Colorado-School-of-Mines-Robotics-Club/MATE_ROV_Electronics/README.md

# MinesROV Electronics
Git Repo for CSM MateROV Electronics
