Colorado-School-of-Mines-Robotics-Club/MATE_ROV_Electronics/Mock Electrical Diagram R2.jpg

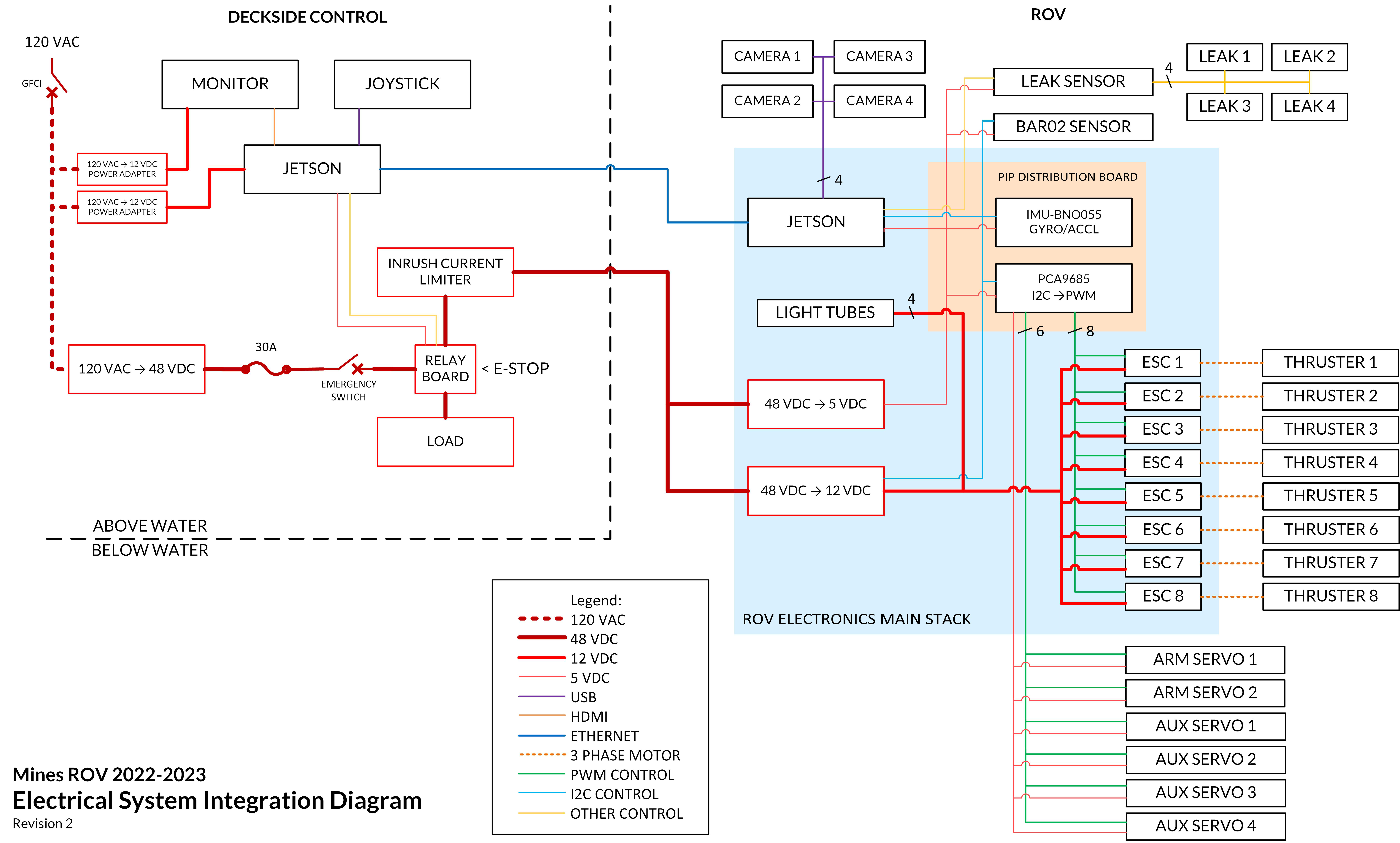
Mock Electrical Diagram R2.jpg
