Colorado-School-of-Mines-Robotics-Club/MATE_ROV_Electronics/2021-2022 Electronics/DCDC_4805/Project Outputs for DCDC_4805/DCDC_4805.xlsx

Comment | Description | Designator | Footprint | LibRef | Quantity
330uF 100V | Panasonic CAP ALUM 330UF 20% 100V SMD | C1 | EEV-FK2A331M | EEV-FK2A331M | 1
15uF 100V | TDK CAP CER 15UF 100V X7S 2220 | C2 | C2220M Generic | C5750X7S2A156M250KB | 1
100uF 10V | Wurth CAP ALUM POLY 100UF 20% 10V SMD | C3, C4, C5, C6 | 865080243007 | 865080243007 | 4
22uF 10V | Wurth CAP CER 22UF 10V X5R 0805 | C7 | 885012107011 | 885012107011 | 1
12V 250mW | Nexperia DIODE ZENER 12V 250MW TO236AB | D1 | BZX84-C12,235 | BZX84-C12,235 | 1
125VDC 5A | Littelfuse FUSE BRD MNT 5A 125VAC/VDC 2SMD | F1 | 0154005.DRL | 0154005.DRL | 1
M3 | MECHANICAL M3 Mounting Hole | H1, H2, H3, H4 | M3_MOUNTING_HOLE | M3_Mounting_Hole | 4
M5x3.5mm | Wurth WP-THRBU REDCUBE THR internal through-hole thread, 10x10mm, M5x3.5mm, 8 pins, 85A | J1, J2 | 74655095 | 74655095R | 2
JST-XH 2POS VERT | JST XH CONN HEADER VERT 2POS 2.5MM | J3, J4, J5, J6, J7, J8, J9, J10, J11, J12, J13, J14, J15, J16, J17, J18, J21 | FP-B2B-XH-A_LF_SN-MFG | B2B-XH-A(LF)(SN) | 17
M3x2.5mm | Wurth WP-THRBU REDCUBE THR internal through-hole thread, 7x7mm, M3x2.5mm, 4 pins, 50A | J19, J20 | 74650073 | 74650073R | 2
100kΩ | Stackpole RES 100K OHM 1% 1/8W 0805 | R1, R2, R3 | RMCF0805 | RMCF0805FT100K | 3
P-CH FET 100V | Infineon MOSFET P-CH 100V 14A D2PAK | U1 | IRF9530NSTRLPBF | IRF9530NSTRLPBF | 1
48V/5V 200W | Flex Power DC DC CONVERTER 5V 200W | U2 | PKB4211DPI | PKB4211DPI | 1
