Colorado-School-of-Mines-Robotics-Club/MATE_ROV_Electronics/2021-2022 Electronics/DCDC_4812/Project Outputs for DCDC_4812/DCDC_4812.xlsx

Comment | Description | Designator | Footprint | LibRef | Quantity
470uF 100V | Vishay CAP ALUM 470UF 20% 100V SMD | C1 | MAL2150_CASE1821 | MAL215099913E3 | 1
15uF 100V | TDK CAP CER 15UF 100V X7S 2220 | C2 | C2220M Generic | C5750X7S2A156M250KB | 1
470uF 16V | Wurth CAP ALUM POLY 470UF 20% 16V SMD | C3, C4, C5, C6 | 875115357006 | 875115357006 | 4
15uF 25V | TDK CAP CER 15UF 25V X5R 0805 | C7 | C2012M Generic | C2012X5R1E156M125AC | 1
12V 250mW | Nexperia DIODE ZENER 12V 250MW TO236AB | D1 | BZX84-C12,235 | BZX84-C12,235 | 1
72VDC 30A | Littelfuse FUSE BOARD MNT 30A 125VAC 72VDC | F1 | 0456030.ER | 0456030.ER | 1
M3 | MECHANICAL M3 Mounting Hole | H1, H2, H3, H4 | M3_MOUNTING_HOLE | M3_Mounting_Hole | 4
M5x3.5mm | Wurth WP-THRBU REDCUBE THR internal through-hole thread, 10x10mm, M5x3.5mm, 8 pins, 85A | J1, J2 | 74655095 | 74655095R | 2
JST-XH 2POS VERT | JST XH CONN HEADER VERT 2POS 2.5MM | J3, J4, J5, J6, J7, J8, J9, J10 | FP-B2B-XH-A_LF_SN-MFG | B2B-XH-A(LF)(SN) | 8
M3x2.5mm | Wurth WP-THRBU REDCUBE THR internal through-hole thread, 7x7mm, M3x2.5mm, 4 pins, 50A | J11, J12, J13, J14, J15, J16, J17, J18, J19, J20, J21, J22, J23, J24, J25, J26 | 74650073 | 74650073R | 16
JST-XH 4POS VERT | JST XH CONN HEADER VERT 4POS 2.5MM | J27 | JST_B4B-XH-A_LF_SN_0 | B4B-XH-A(LF)(SN) | 1
100kΩ | Stackpole RES 100K OHM 1% 1/8W 0805 | R1, R2, R3 | RMCF0805 | RMCF0805FT100K | 3
P-CH FET 75V | ON Semi MOSFET P-CH 75V 100A D2PAK | U1 | SMP3003-DL-1E | SMP3003-DL-1E | 1
48V/12V DC-DC Converter | Flex Power DC DC CONVERTER 12V 1300W | U2 | BMR4800116/005 | BMR4800116/005 | 1
