Colorado-School-of-Mines-Robotics-Club/MATE_ROV_Electronics/2021-2022 Electronics/PWMSignalSplitter/Project Outputs for PWMSignalSplitter/PWMSignalSplitter.xlsx

Comment | Description | Designator | Footprint | LibRef | Quantity
JST-XH 3POS R/A | JST XH CONN HEADER R/A 3POS 2.5MM | J1 | S3B-XH-A(LF)(SN) | S3B-XH-A(LF)(SN) | 1
JST-XH 2POS R/A | JST XH CONN HEADER R/A 2POS 2.5MM | J2, J3 | S2B-XH-A(LF)(SN) | S2B-XH-A(LF)(SN) | 2
