Colorado-School-of-Mines-Robotics-Club/MATE_ROV_Electronics/2021-2022 Electronics/PWMSignalSplitter/PWMSignalSplitter.step

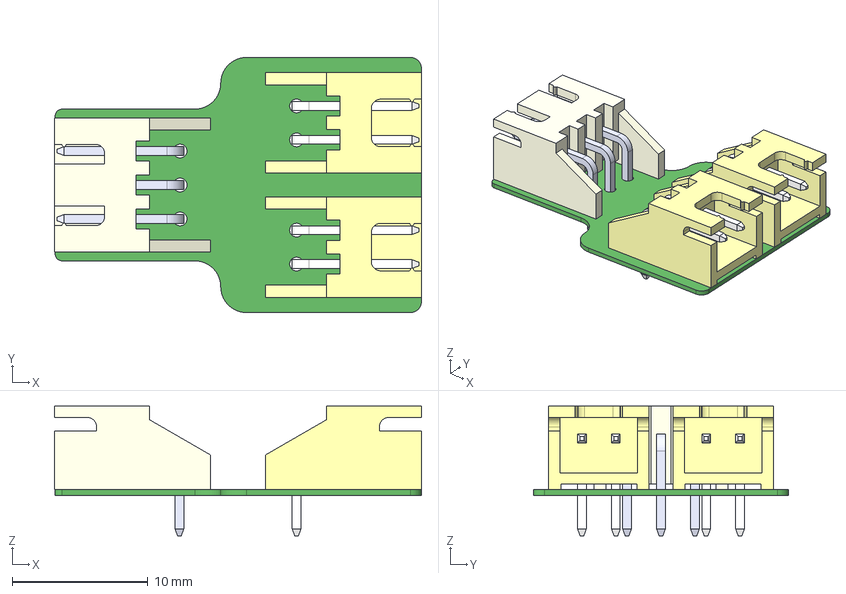
[picture p2: CAD file, 2022-07-29]
2021-2022 Electronics/PWMSignalSplitter/PWMSignalSplitter.step
27.0 x 18.8 x 9.55 mm
