Colorado-School-of-Mines-Robotics-Club/MATE_ROV_Electronics/(list of files, drawings)

Other design files:
2021-2022 Electronics/ConverterModule12V18A/ConverterModule12V18A.PrjPcb
2021-2022 Electronics/ConverterModule12V18A/ConverterModule12V18A.SchDoc
2021-2022 Electronics/DCDC_4805/DCDC_4805.PcbDoc
2021-2022 Electronics/DCDC_4805/DCDC_4805.PrjPcb
2021-2022 Electronics/DCDC_4805/DCDC_4805.SchDoc
2021-2022 Electronics/DCDC_4812/DCDC_4812.PcbDoc
2021-2022 Electronics/DCDC_4812/DCDC_4812.PrjPcb
2021-2022 Electronics/DCDC_4812/DCDC_4812.SchDoc
2021-2022 Electronics/ESCBackerBoard/B2B_Connectors.SchDoc
2021-2022 Electronics/ESCBackerBoard/ConverterModule12V18A.SchDoc
2021-2022 Electronics/ESCBackerBoard/ESCBackerBoard.PcbDoc
2021-2022 Electronics/ESCBackerBoard/ESCBackerBoard.PrjPcb
2021-2022 Electronics/ESCBackerBoard/Top.SchDoc
2021-2022 Electronics/PWMSignalSplitter/PWMSignalSplitter.PcbDoc
2021-2022 Electronics/PWMSignalSplitter/PWMSignalSplitter.PrjPcb
2021-2022 Electronics/PWMSignalSplitter/PWMSignalSplitter.SchDoc
