Colorado-School-of-Mines-Robotics-Club/MATE_ROV_Electronics/(threads)

Thread 1 (2022-07-06):

Redesign ESC Backer Boards

yameatmeyourdead, 2022-07-06:
ESC Backerboards need to be redesigned to fit new form factor and to fix previous issues with trace clearance. Consider use of capacitors/resistors already available in EDC/EE Labs.

Closed 2022-07-08.

Thread 4 (2022-07-08):

ESC Backerboard Redesign

ecic2002, 2022-07-08:
#-Analyze the failure conditions of last year’s backer boards
-Design to fit our new form factor.
-Look into power delivery options through the PCB instead of wired.
-Look into new options of how to mount ESC to boards
-Consider how to make the boards hot-swappable. No soldering or messing around with wires to switch out a board. Avoid having to remove multiple other components to get to boards.
-Consider thermal output of ESCs, see thermal design study from mechanical: -----
-Consider hardware/components already available in EE labs at Mines.

Closed 2023-01-18.

Thread 5 (2022-07-08):

12V Convertor redesign

ecic2002, 2022-07-08:
-Create a new layout for the PCB that fits our new layout
-Determine if current board design sufficiently outputs required power
-Look into options of viewing power draw and temp.
-Consider efficiency and thermal output of the converter.

Thread 6 (2022-07-08):

5V Convertor redesign

ecic2002, 2022-07-08:

ecic2002, 2022-07-08:
https://www.digikey.com/en/products/detail/flex-power-modules/PKB4211DPI/10287630

Thread 7 (2022-07-08):

PIP Board Design

ecic2002, 2022-07-08:
PWM, I2C, & Power Distribution Board
-Refers to the board which was hand soldered together last year. Holds the IMU and I2C to PWM chip, as well as PIC microcontroller if implemented. Also provided as power and signal delivery to the servos.
-Design dependent on:
-Consider hardware/components already available in EE labs at Mines.
-Make room for leak sensor, barometer, and all listed below.
-PCA9685 will be on board
-Fit new form factor
-Similar connectors as last year to facilitate everything.

Board needs to contain:
From/To Jetson:
-3.3v Rail (from)  <-We might not need this
-5v Rail (to)
-Gnd
-I2C SDA
-I2C SDL
-Interrupt pins

From 5v Convertor
-5v Rail
-Gnd

From 12v Convertor
-12v Rail
-Gnd

Header for IMU
-I2C SDA
-I2C SDL
-Gnd
-5v Rail?

Output to Thrusters x 8
-Gnd
-PWM Signal

Output to Servos x 6
-5v Rail
-Gnd
-PWM Signal

Output to Barometer
-I2C SDA
-I2C SDL
-Gnd
-5v Rail?

Output to Leak Sensors
-Interrupt Pin to Jetson
-Gnd
-5v Rail?

Output to Light Tube/Other Power
-12v Rail?
-Gnd

PCA9685
-5v Rail?
-Gnd
-Supporting Electronics
-I2C SDA
-I2C SDL
- PWM signal outputs

? - To be confirmed

ecic2002, 2022-07-14:
Links:
[Leak Sensor](https://bluerobotics.com/store/sensors-sonars-cameras/leak-sensor/sos-leak-sensor/)
[Barometer](https://bluerobotics.com/store/sensors-sonars-cameras/sensors/bar02-sensor-r1-rp/)
[IMU](https://learn.adafruit.com/adafruit-bno055-absolute-orientation-sensor)

ecic2002, 2022-07-14:
In the interest of time/budget, this year we will stick to using PWM to control the thrusters instead of DSHOT. The pic microcontroller does not need to be included in this years PCS board.

Closed 2023-01-18.

Thread 9 (2022-07-08):

Dshot Control of ESCs

ecic2002, 2022-07-08:

ecic2002, 2022-07-14:
In the interest of time/budget, this year we will stick to using PWM to control the thrusters instead of DSHOT. The pic microcontroller does not need to be included in this years PCS board. This issue has been benched
